Copper280z/nucleo144_driver_breakout/nucleo_driver_breakout/nucleo_driver_breakout.kicad_pcb

## KiCad design nucleo_driver_breakout/nucleo_driver_breakout.kicad_pcb (2024-06-16)

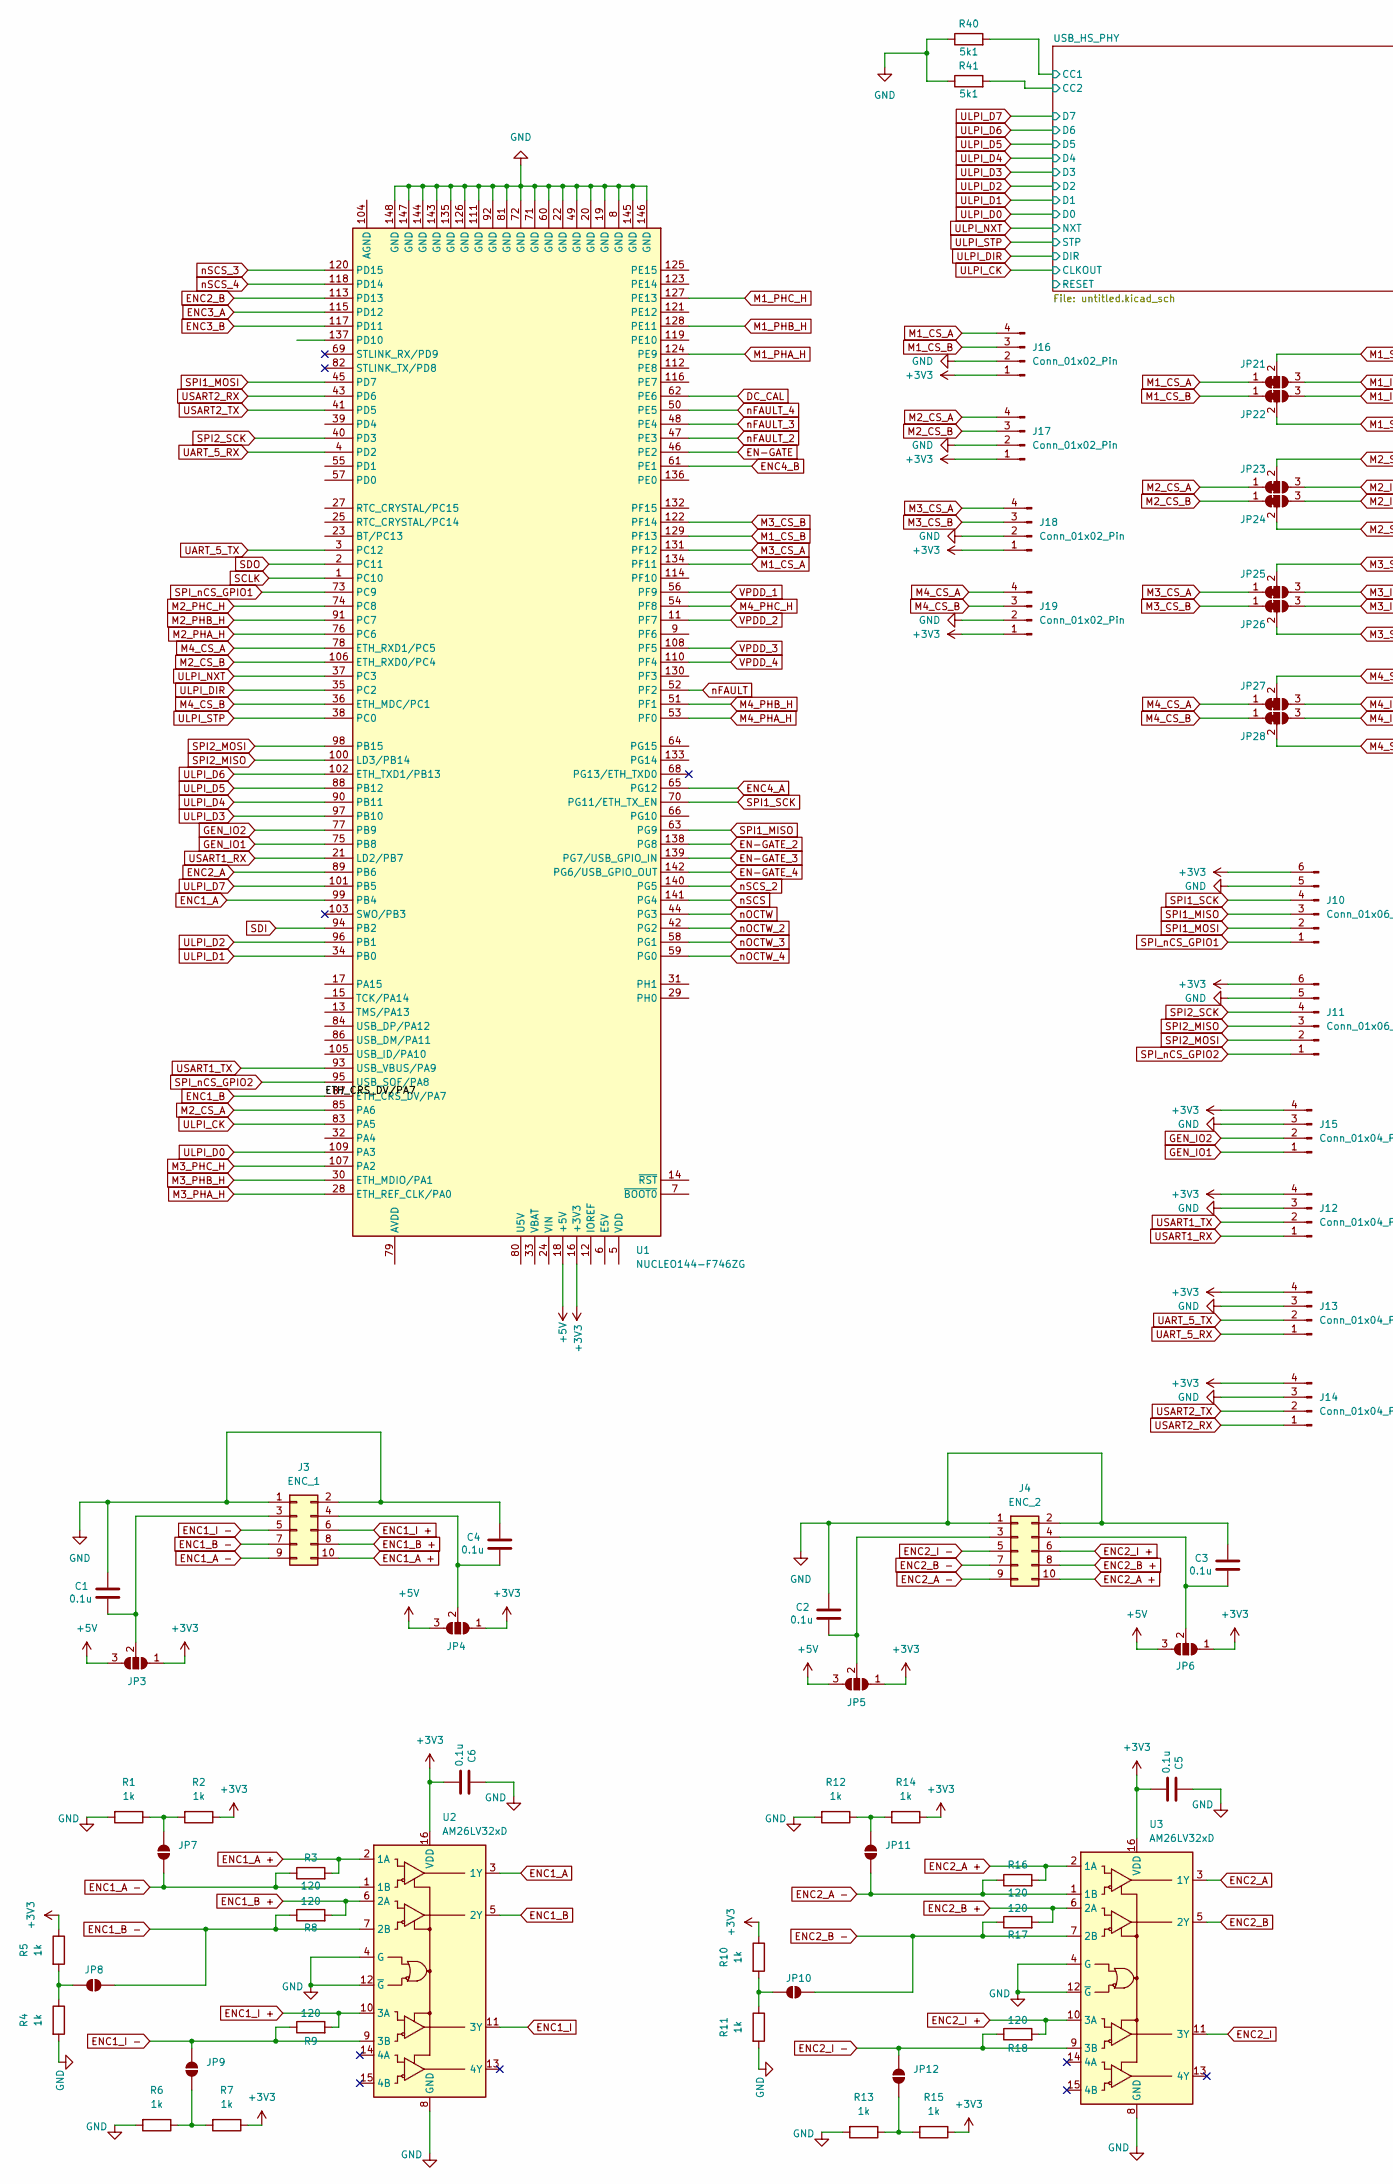
[picture p1: schematic nucleo_driver_breakout.kicad_sch, part in row 1, column 1]

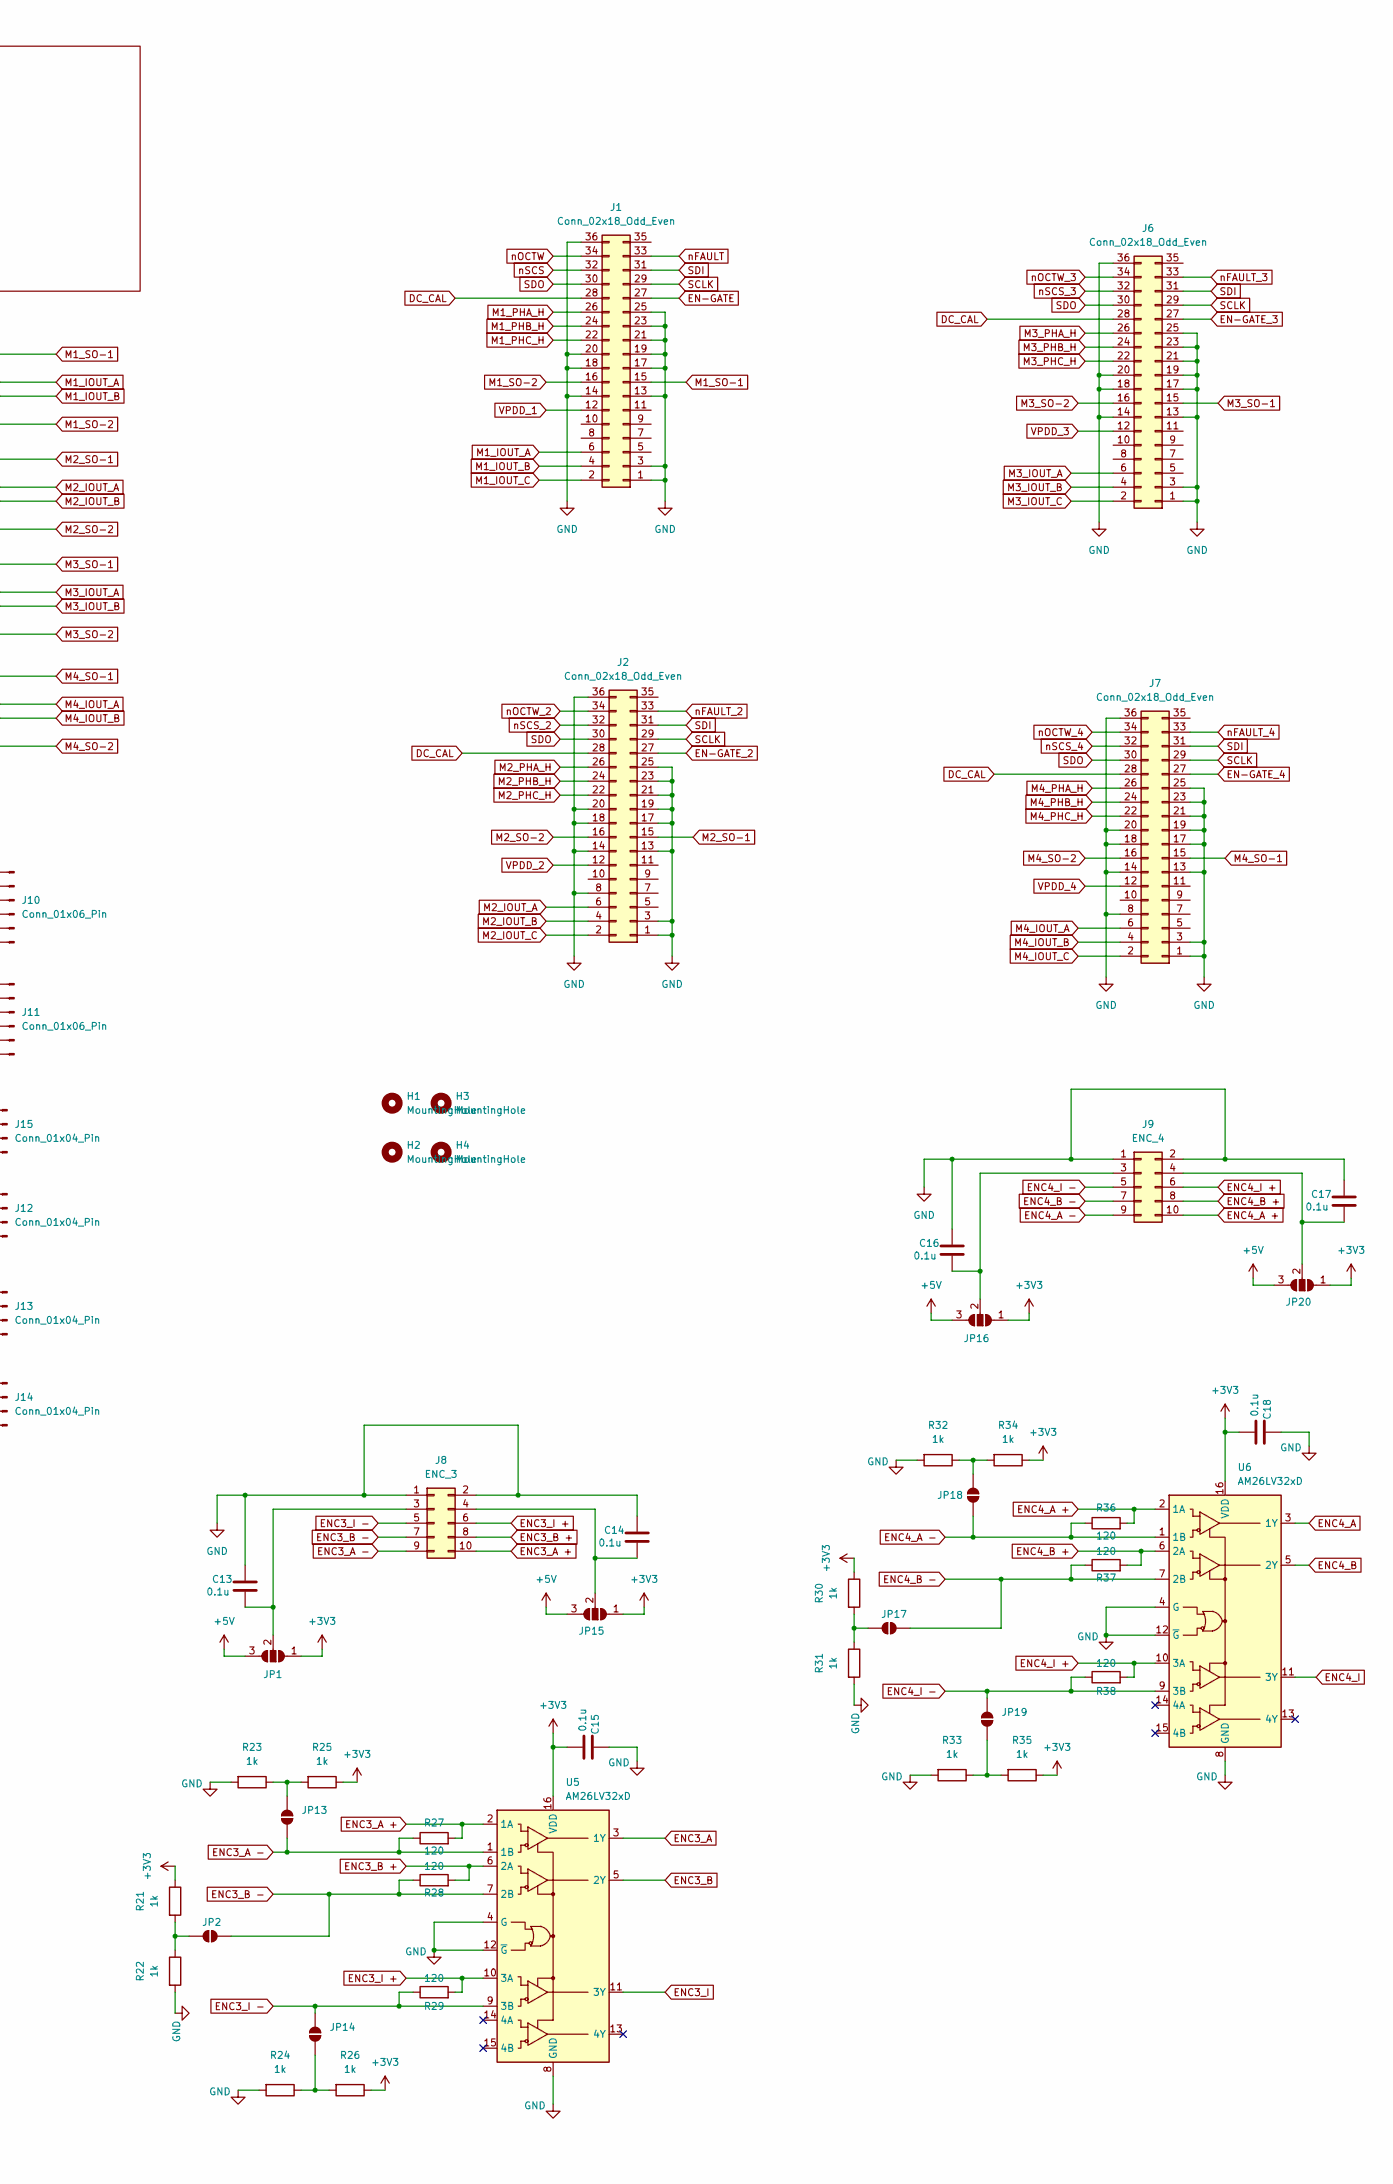
[picture p2: schematic nucleo_driver_breakout.kicad_sch, part in row 1, column 2]

Parts:
C1, C2, C3, C4, C5, C6, C13, C14, C15, C16, C17, C18: 0.1u; C_0402_1005Metric; LCSC ID C1525
H1, H2, H3, H4: MountingHole; MountingHole_3.2mm_M3_ISO7380
J1, J2, J6, J7: Conn_02x18_Odd_Even; PinHeader_2x18_P2.54mm_Vertical
J3: ENC_1; PinHeader_2x05_P2.54mm_Vertical
J4: ENC_2; PinHeader_2x05_P2.54mm_Vertical
J8: ENC_3; PinHeader_2x05_P2.54mm_Vertical
J9: ENC_4; PinHeader_2x05_P2.54mm_Vertical
J10, J11: Conn_01x06_Pin; JST_EH_B6B-EH-A_1x06_P2.50mm_Vertical
J12, J13, J14, J15: Conn_01x04_Pin; JST_EH_B4B-EH-A_1x04_P2.50mm_Vertical
J16, J17, J18, J19: Conn_01x02_Pin; JST_EH_B4B-EH-A_1x04_P2.50mm_Vertical
JP1, JP3, JP4, JP5, JP6, JP15, JP16, JP20: SolderJumper_3_Open; SolderJumper-3_P1.3mm_Open_RoundedPad1.0x1.5mm
JP2, JP7, JP8, JP9, JP10, JP11, JP12, JP13, JP14, JP17, JP18, JP19: SolderJumper_2_Open; SolderJumper-2_P1.3mm_Open_RoundedPad1.0x1.5mm
JP21, JP22, JP23, JP24, JP25, JP26, JP27, JP28: SolderJumper_3_Bridged12; SolderJumper-3_P1.3mm_Bridged12_RoundedPad1.0x1.5mm
R1, R2, R4, R5, R6, R7, R10, R11, R12, R13, R14, R15, R21, R22, R23, R24, R25, R26, R30, R31, R32, R33, R34, R35: 1k; R_0402_1005Metric; LCSC ID C11702
R3, R8, R9, R16, R17, R18, R27, R28, R29, R36, R37, R38: 120; R_1206_3216Metric; LCSC ID C17909
R40: 5k1; R_0402_1005Metric; LCSC ID C25079
R41: 5k1; R_0402_1005Metric; LCSC ID C25905
U1: NUCLEO144-F746ZG; ST_Morpho_Connector_144_STLink
U2, U3, U5, U6: AM26LV32xD; SOIC-16_3.9x9.9mm_P1.27mm; LCSC ID C524786

Connections:
+3V3: C5.2, C6.2, C15.2, C18.2, J10.6, J11.6, J12.4, J13.4, J14.4, J15.4, J16.1, J17.1, J18.1, J19.1, JP1.1 (A), JP3.1 (A), JP4.1 (A), JP5.1 (A), JP6.1 (A), JP15.1 (A), JP16.1 (A), JP20.1 (A), R2.1, R5.1, R7.1, R10.1, R14.1, R15.1, R21.1, R25.1, R26.1, R30.1, R34.1, R35.1, U1.16 (+3V3), U2.16 (VDD), U3.16 (VDD), U5.16 (VDD), U6.16 (VDD); also elsewhere on the board
+5V: JP1.3 (B), JP3.3 (B), JP4.3 (B), JP5.3 (B), JP6.3 (B), JP15.3 (B), JP16.3 (B), JP20.3 (B), U1.18 (+5V)
/USB_HS_PHY/CC1: R40.2; also elsewhere on the board
/USB_HS_PHY/CC2: R41.2; also elsewhere on the board
DC_CAL: J1.28, J2.28, J6.28, J7.28, U1.62 (PE6)
EN-GATE: J1.27, U1.46 (PE2)
EN-GATE_2: J2.27, U1.138 (PG8)
EN-GATE_3: J6.27, U1.139 (PG7/USB_GPIO_IN)
EN-GATE_4: J7.27, U1.142 (PG6/USB_GPIO_OUT)
ENC1_A: U1.99 (PB4), U2.3 (1Y)
ENC1_A +: J3.10, R3.2, U2.2 (1A)
ENC1_A -: J3.9, JP7.1 (A), R3.1, U2.1 (1B)
ENC1_B: U1.87 (ETH_CRS_DV/PA7), U2.5 (2Y)
ENC1_B +: J3.8, R8.2, U2.6 (2A)
ENC1_B -: J3.7, JP8.1 (A), R8.1, U2.7 (2B)
ENC1_I: U2.11 (3Y)
ENC1_I +: J3.6, R9.2, U2.10 (3A)
ENC1_I -: J3.5, JP9.1 (A), R9.1, U2.9 (3B)
ENC2_A: U1.89 (PB6), U3.3 (1Y)
ENC2_A +: J4.10, R16.2, U3.2 (1A)
ENC2_A -: J4.9, JP11.1 (A), R16.1, U3.1 (1B)
ENC2_B: U1.113 (PD13), U3.5 (2Y)
ENC2_B +: J4.8, R17.2, U3.6 (2A)
ENC2_B -: J4.7, JP10.1 (A), R17.1, U3.7 (2B)
ENC2_I: U3.11 (3Y)
ENC2_I +: J4.6, R18.2, U3.10 (3A)
ENC2_I -: J4.5, JP12.1 (A), R18.1, U3.9 (3B)
ENC3_A: U1.115 (PD12), U5.3 (1Y)
ENC3_A +: J8.10, R27.2, U5.2 (1A)
ENC3_A -: J8.9, JP13.1 (A), R27.1, U5.1 (1B)
ENC3_B: U1.117 (PD11), U5.5 (2Y)
ENC3_B +: J8.8, R28.2, U5.6 (2A)
ENC3_B -: J8.7, JP2.1 (A), R28.1, U5.7 (2B)
ENC3_I: U5.11 (3Y)
ENC3_I +: J8.6, R29.2, U5.10 (3A)
ENC3_I -: J8.5, JP14.1 (A), R29.1, U5.9 (3B)
ENC4_A: U1.65 (PG12), U6.3 (1Y)
ENC4_A +: J9.10, R36.2, U6.2 (1A)
ENC4_A -: J9.9, JP18.1 (A), R36.1, U6.1 (1B)
ENC4_B: U1.61 (PE1), U6.5 (2Y)
ENC4_B +: J9.8, R37.2, U6.6 (2A)
ENC4_B -: J9.7, JP17.1 (A), R37.1, U6.7 (2B)
ENC4_I: U6.11 (3Y)
ENC4_I +: J9.6, R38.2, U6.10 (3A)
ENC4_I -: J9.5, JP19.1 (A), R38.1, U6.9 (3B)
GEN_IO1: J15.1, U1.75 (PB8)
GEN_IO2: J15.2, U1.77 (PB9)
GND: C1.1, C2.1, C3.1, C4.1, C5.1, C6.1, C13.1, C14.1, C15.1, C16.1, C17.1, C18.1, J1.1, J1.3, J1.13, J1.14, J1.17, J1.18, J1.19, J1.20, J1.21, J1.23, J1.25, J1.36, J2.1, J2.3, J2.8, J2.13, J2.14, J2.17, J2.18, J2.19, J2.20, J2.21, J2.23, J2.25, J2.36, J3.1, J3.2, J4.1, J4.2, J6.1, J6.3, J6.13, J6.14, J6.17, J6.18, J6.19, J6.20, J6.21, J6.23, J6.25, J6.36, J7.1, J7.3, J7.8, J7.13, J7.14, J7.17, J7.18, J7.19, J7.20, J7.21, J7.23, J7.25, J7.36, J8.1, J8.2, J9.1, J9.2, J10.5, J11.5, J12.3, J13.3, J14.3, J15.3, J16.2, J17.2, J18.2, J19.2, R1.2, R4.2, R6.2, R11.2, R12.2, R13.2, R22.2, R23.2, R24.2, R31.2, R32.2, R33.2, R40.1, R41.1, U1.8 (GND), U1.19 (GND), U1.20 (GND), U1.22 (GND), U1.49 (GND), U1.60 (GND), U1.71 (GND), U1.72 (GND), U1.81 (GND), U1.92 (GND), U1.111 (GND), U1.126 (GND), U1.135 (GND), U1.143 (GND), U1.144 (GND), U1.145 (GND), U1.146 (GND), U1.147 (GND), U1.148 (GND), U2.4 (G), U2.8 (GND), U2.12 (~G), U3.4 (G), U3.8 (GND), U3.12 (~G), U5.4 (G), U5.8 (GND), U5.12 (~G), U6.4 (G), U6.8 (GND), U6.12 (~G); also elsewhere on the board
M1_CS_A: J16.4, JP21.1 (A), U1.134 (PF11)
M1_CS_B: J16.3, JP22.1 (A), U1.129 (PF13)
M1_IOUT_A: J1.6, JP21.3 (B)
M1_IOUT_B: J1.4, JP22.3 (B)
M1_IOUT_C: J1.2
M1_PHA_H: J1.26, U1.124 (PE9)
M1_PHB_H: J1.24, U1.128 (PE11)
M1_PHC_H: J1.22, U1.127 (PE13)
M1_SO-1: J1.15, JP21.2 (C)
M1_SO-2: J1.16, JP22.2 (C)
M2_CS_A: J17.4, JP23.1 (A), U1.85 (PA6)
M2_CS_B: J17.3, JP24.1 (A), U1.106 (ETH_RXD0/PC4)
M2_IOUT_A: J2.6, JP23.3 (B)
M2_IOUT_B: J2.4, JP24.3 (B)
M2_IOUT_C: J2.2
M2_PHA_H: J2.26, U1.76 (PC6)
M2_PHB_H: J2.24, U1.91 (PC7)
M2_PHC_H: J2.22, U1.74 (PC8)
M2_SO-1: J2.15, JP23.2 (C)
M2_SO-2: J2.16, JP24.2 (C)
M3_CS_A: J18.4, JP25.1 (A), U1.131 (PF12)
M3_CS_B: J18.3, JP26.1 (A), U1.122 (PF14)
M3_IOUT_A: J6.6, JP25.3 (B)
M3_IOUT_B: J6.4, JP26.3 (B)
M3_IOUT_C: J6.2
M3_PHA_H: J6.26, U1.28 (ETH_REF_CLK/PA0)
M3_PHB_H: J6.24, U1.30 (ETH_MDIO/PA1)
M3_PHC_H: J6.22, U1.107 (PA2)
M3_SO-1: J6.15, JP25.2 (C)
M3_SO-2: J6.16, JP26.2 (C)
M4_CS_A: J19.4, JP27.1 (A), U1.78 (ETH_RXD1/PC5)
M4_CS_B: J19.3, JP28.1 (A), U1.36 (ETH_MDC/PC1)
M4_IOUT_A: J7.6, JP27.3 (B)
M4_IOUT_B: J7.4, JP28.3 (B)
M4_IOUT_C: J7.2
M4_PHA_H: J7.26, U1.53 (PF0)
M4_PHB_H: J7.24, U1.51 (PF1)
M4_PHC_H: J7.22, U1.54 (PF8)
M4_SO-1: J7.15, JP27.2 (C)
M4_SO-2: J7.16, JP28.2 (C)
unnamed: C1.2, J3.3, JP3.2 (C)
unnamed: C4.2, J3.4, JP4.2 (C)
unnamed: C2.2, J4.3, JP5.2 (C)
unnamed: C3.2, J4.4, JP6.2 (C)
unnamed: C13.2, J8.3, JP1.2 (C)
unnamed: C14.2, J8.4, JP15.2 (C)
unnamed: C16.2, J9.3, JP16.2 (C)
unnamed: C17.2, J9.4, JP20.2 (C)
unnamed: JP2.2 (B), R21.2, R22.1
unnamed: JP7.2 (B), R1.1, R2.2
unnamed: JP8.2 (B), R4.1, R5.2
unnamed: JP9.2 (B), R6.1, R7.2
unnamed: JP10.2 (B), R10.2, R11.1
unnamed: JP11.2 (B), R12.1, R14.2
unnamed: JP12.2 (B), R13.1, R15.2
unnamed: JP13.2 (B), R23.1, R25.2
unnamed: JP14.2 (B), R24.1, R26.2
unnamed: JP17.2 (B), R30.2, R31.1
unnamed: JP18.2 (B), R32.1, R34.2
unnamed: JP19.2 (B), R33.1, R35.2
SCLK: J1.29, J2.29, J6.29, J7.29, U1.1 (PC10)
SDI: J1.31, J2.31, J6.31, J7.31, U1.94 (PB2)
SDO: J1.30, J2.30, J6.30, J7.30, U1.2 (PC11)
SPI1_MISO: J10.3, U1.63 (PG9)
SPI1_MOSI: J10.2, U1.45 (PD7)
SPI1_SCK: J10.4, U1.70 (PG11/ETH_TX_EN)
SPI2_MISO: J11.3, U1.100 (LD3/PB14)
SPI2_MOSI: J11.2, U1.98 (PB15)
SPI2_SCK: J11.4, U1.40 (PD3)
SPI_nCS_GPIO1: J10.1, U1.73 (PC9)
SPI_nCS_GPIO2: J11.1, U1.95 (USB_SOF/PA8)
UART_5_RX: J13.1, U1.4 (PD2)
UART_5_TX: J13.2, U1.3 (PC12)
ULPI_CK: U1.83 (PA5); also elsewhere on the board
ULPI_D0: U1.109 (PA3); also elsewhere on the board
ULPI_D1: U1.34 (PB0); also elsewhere on the board
ULPI_D2: U1.96 (PB1); also elsewhere on the board
ULPI_D3: U1.97 (PB10); also elsewhere on the board
ULPI_D4: U1.90 (PB11); also elsewhere on the board
ULPI_D5: U1.88 (PB12); also elsewhere on the board
ULPI_D6: U1.102 (ETH_TXD1/PB13); also elsewhere on the board
ULPI_D7: U1.101 (PB5); also elsewhere on the board
ULPI_DIR: U1.35 (PC2); also elsewhere on the board
ULPI_NXT: U1.37 (PC3); also elsewhere on the board
ULPI_STP: U1.38 (PC0); also elsewhere on the board
USART1_RX: J12.1, U1.21 (LD2/PB7)
USART1_TX: J12.2, U1.93 (USB_VBUS/PA9)
USART2_RX: J14.1, U1.43 (PD6)
USART2_TX: J14.2, U1.41 (PD5)
VPDD_1: J1.12, U1.56 (PF9)
VPDD_2: J2.12, U1.11 (PF7)
VPDD_3: J6.12, U1.108 (PF5)
VPDD_4: J7.12, U1.110 (PF4)
nFAULT: J1.33, U1.52 (PF2)
nFAULT_2: J2.33, U1.47 (PE3)
nFAULT_3: J6.33, U1.48 (PE4)
nFAULT_4: J7.33, U1.50 (PE5)
nOCTW: J1.34, U1.44 (PG3)
nOCTW_2: J2.34, U1.42 (PG2)
nOCTW_3: J6.34, U1.58 (PG1)
nOCTW_4: J7.34, U1.59 (PG0)
nSCS: J1.32, U1.141 (PG4)
nSCS_2: J2.32, U1.140 (PG5)
nSCS_3: J6.32, U1.120 (PD15)
nSCS_4: J7.32, U1.118 (PD14)

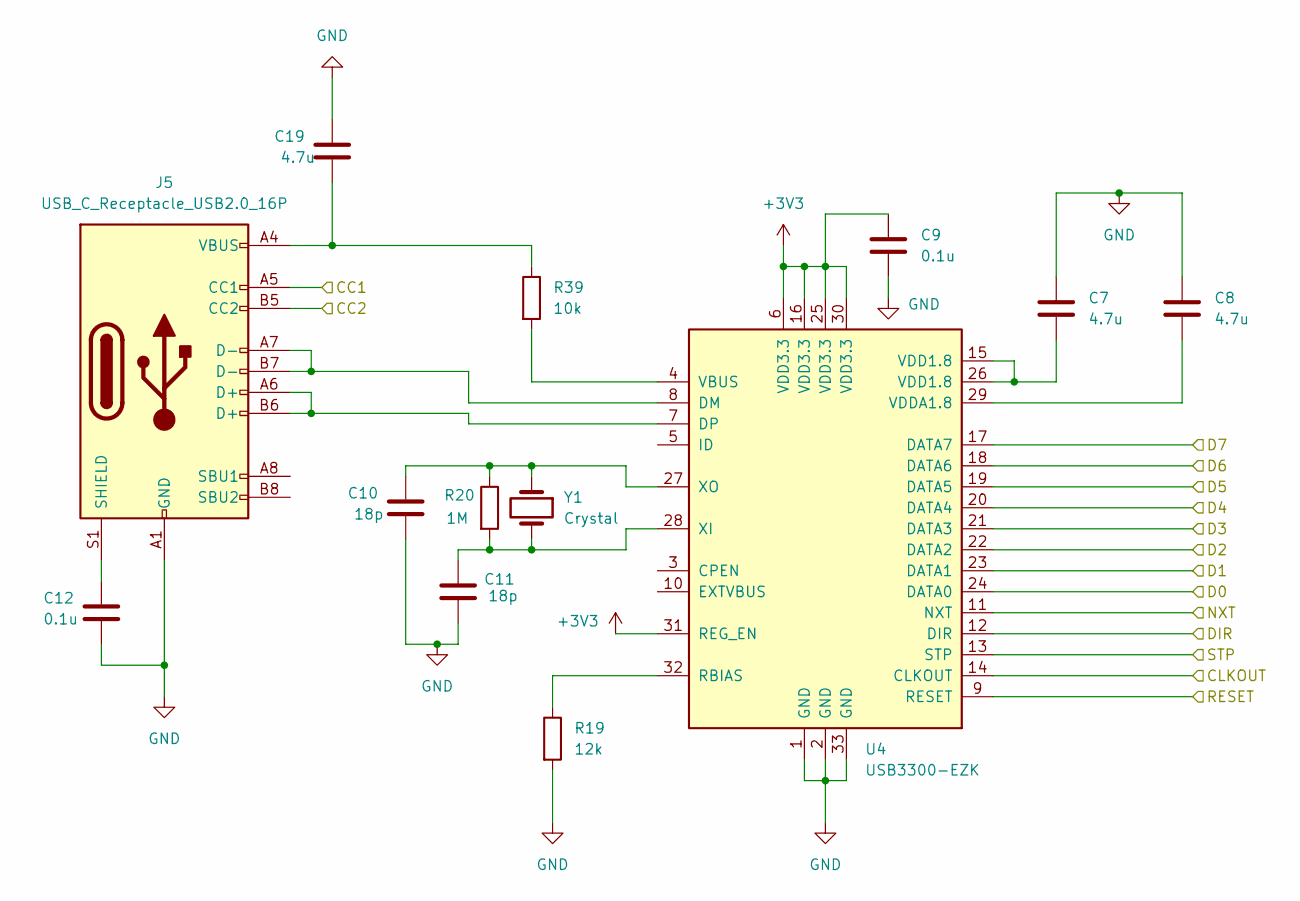
[picture p3: schematic untitled.kicad_sch]

Parts:
C7, C8: 4.7u; C_0402_1005Metric; LCSC ID C2858031
C9, C12: 0.1u; C_0402_1005Metric; LCSC ID C1525
C10, C11: 18p; C_0402_1005Metric; LCSC ID C1512022
C19: 4.7u; C_0402_1005Metric; LCSC ID C695126
J5: USB_C_Receptacle_USB2.0_16P; USB_C_Receptacle_G-Switch_GT-USB-7010ASV; LCSC ID C2988369
R19: 12k; R_0402_1005Metric; LCSC ID C25752
R20: 1M; R_0402_1005Metric
R39: 10k; R_0402_1005Metric; LCSC ID C25744
U4: USB3300-EZK; QFN-32-1EP_5x5mm_P0.5mm_EP3.45x3.45mm; LCSC ID C108383
Y1: Crystal; Crystal_SMD_Qantek_QC5CB-2Pin_5x3.2mm; LCSC ID C1985382

Connections:
+3V3: C9.1, U4.6 (VDD3.3), U4.16 (VDD3.3), U4.25 (VDD3.3), U4.30 (VDD3.3), U4.31 (REG_EN); also elsewhere on the board
/USB_HS_PHY/CC1: J5.A5 (CC1); also elsewhere on the board
/USB_HS_PHY/CC2: J5.B5 (CC2); also elsewhere on the board
/USB_HS_PHY/RESET: U4.9 (RESET)
GND: C7.1, C8.1, C9.2, C10.2, C11.2, C12.2, C19.1, J5.A1 (GND), J5.A12 (GND), J5.B1 (GND), J5.B12 (GND), R19.2, U4.1 (GND), U4.2 (GND), U4.33 (GND); also elsewhere on the board
unnamed: C7.2, U4.15 (VDD1.8), U4.26 (VDD1.8)
unnamed: C19.2, J5.A4 (VBUS), J5.A9 (VBUS), J5.B4 (VBUS), J5.B9 (VBUS), R39.1
unnamed: C12.1, J5.S1 (SHIELD)
unnamed: J5.A7 (D-), J5.B7 (D-), U4.8 (DM)
unnamed: J5.A6 (D+), J5.B6 (D+), U4.7 (DP)
unnamed: R19.1, U4.32 (RBIAS)
unnamed: R39.2, U4.4 (VBUS)
unnamed: C8.2, U4.29 (VDDA1.8)
unnamed: C11.1, R20.2, U4.28 (XI), Y1.2
unnamed: C10.1, R20.1, U4.27 (XO), Y1.1
ULPI_CK: U4.14 (CLKOUT); also elsewhere on the board
ULPI_D0: U4.24 (DATA0); also elsewhere on the board
ULPI_D1: U4.23 (DATA1); also elsewhere on the board
ULPI_D2: U4.22 (DATA2); also elsewhere on the board
ULPI_D3: U4.21 (DATA3); also elsewhere on the board
ULPI_D4: U4.20 (DATA4); also elsewhere on the board
ULPI_D5: U4.19 (DATA5); also elsewhere on the board
ULPI_D6: U4.18 (DATA6); also elsewhere on the board
ULPI_D7: U4.17 (DATA7); also elsewhere on the board
ULPI_DIR: U4.12 (DIR); also elsewhere on the board
ULPI_NXT: U4.11 (NXT); also elsewhere on the board
ULPI_STP: U4.13 (STP); also elsewhere on the board

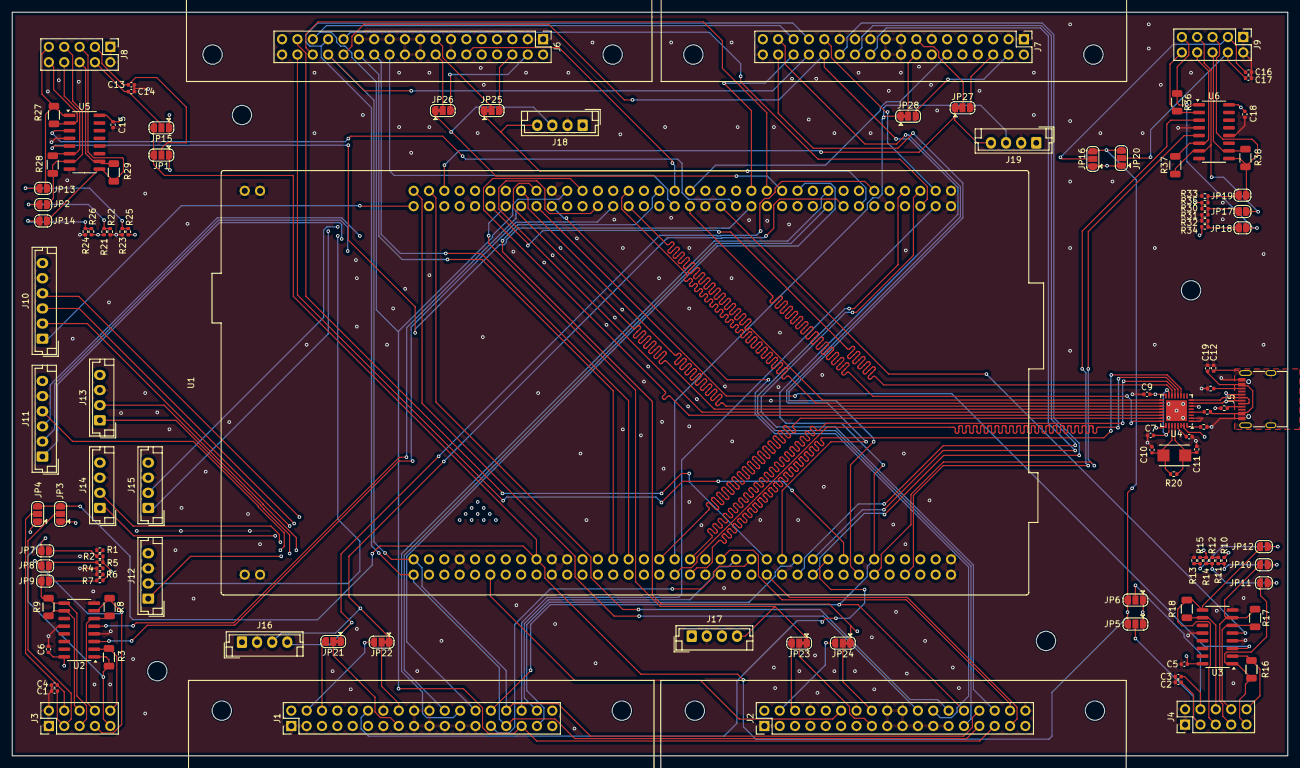
[picture p4: board nucleo_driver_breakout.kicad_pcb from above]

Board: 4 copper layers, 211.0 x 123.0 mm, 118 parts (0 on the bottom side), 155 nets.
