Copper280z/nucleo144_driver_breakout/nucleo_driver_board.ioc

Mcu.UserName=STM32H723ZGTx
PA0.GPIO_Label=M3_PHA_TIM2_CH1
PA0.Signal=S_TIM2_CH1_ETR
PA1.GPIO_Label=M3_PHB_TIM2_CH2
PA1.Signal=S_TIM2_CH2
PA13(JTMS/SWDIO).Signal=DEBUG_JTMS-SWDIO
PA14(JTCK/SWCLK).Signal=DEBUG_JTCK-SWCLK
PA15(JTDI).Signal=GPIO_Output
PA2.GPIO_Label=M3_PHC_TIM2_CH3
PA2.Signal=S_TIM2_CH3
PA3.Signal=USB_OTG_HS_ULPI_D0
PA5.Signal=USB_OTG_HS_ULPI_CK
PA6.GPIO_Label=M2_CS_A_ADC1_IN3
PA6.Signal=ADCx_INP3
PA7.GPIO_Label=ENC1_B_TIM3_CH2
PA7.Signal=S_TIM3_CH2
PA8.Signal=GPIO_Output
PA9.Signal=USART1_TX
PB0.Signal=USB_OTG_HS_ULPI_D1
PB1.Signal=USB_OTG_HS_ULPI_D2
PB10.Signal=USB_OTG_HS_ULPI_D3
PB11.Signal=USB_OTG_HS_ULPI_D4
PB12.Signal=USB_OTG_HS_ULPI_D5
PB13.Signal=USB_OTG_HS_ULPI_D6
PB14.Signal=SPI2_MISO
PB15.Signal=SPI2_MOSI
PB2.GPIO_Label=MDRV_SDI_SPI3_MOSI
PB2.Signal=SPI3_MOSI
PB3(JTDO/TRACESWO).Signal=DEBUG_JTDO-SWO
PB4(NJTRST).GPIO_Label=ENC1_A_TIM3_CH1
PB4(NJTRST).Signal=S_TIM3_CH1
PB5.Signal=USB_OTG_HS_ULPI_D7
PB6.GPIO_Label=ENC2_A_TIM4_CH1
PB6.Signal=S_TIM4_CH1
PB7.Signal=USART1_RX
PC0.Signal=USB_OTG_HS_ULPI_STP
PC1.GPIO_Label=M4_CS_B_ADC2_IN11
PC1.Signal=ADCx_INP11
PC10.GPIO_Label=MDRV_SCLK_SPI3_SCK
PC10.Signal=SPI3_SCK
PC11.GPIO_Label=MDRV_SDO_SPI3_MISO
PC11.Signal=SPI3_MISO
PC12.Signal=UART5_TX
PC13.GPIO_Label=USR_BTN
PC13.Signal=GPIO_Input
PC2_C.Signal=USB_OTG_HS_ULPI_DIR
PC3_C.Signal=USB_OTG_HS_ULPI_NXT
PC4.GPIO_Label=M2_CS_B_ADC2_IN4
PC4.Signal=ADCx_INP4
PC5.GPIO_Label=M4_CS_A_ADC1_IN8
PC5.Signal=ADCx_INP8
PC6.GPIO_Label=M2_PHA_TIM8_CH1
PC6.Signal=S_TIM8_CH1
PC7.GPIO_Label=M2_PHB_TIM8_CH2
PC7.Signal=S_TIM8_CH2
PC8.GPIO_Label=M2_PHC_TIM8_CH3
PC8.Signal=S_TIM8_CH3
PC9.GPIO_Label=AUX_SPI_nCS
PC9.Signal=GPIO_Output
PD0.Signal=GPIO_Output
PD1.Signal=GPIO_Output
PD11.GPIO_Label=ENC3_B_LPTIM2_IN2
PD11.Signal=LPTIM2_IN2
PD12.GPIO_Label=ENC3_A_LPTIM2_IN1
PD12.Signal=LPTIM2_IN1
PD13.GPIO_Label=ENC2_B_TIM4_CH2
PD13.Signal=S_TIM4_CH2
PD14.GPIO_Label=nSCS_4
PD14.Signal=GPIO_Output
PD15.GPIO_Label=nSCS_3
PD15.Signal=GPIO_Output
PD2.Signal=UART5_RX
PD3.Signal=SPI2_SCK
PD5.Signal=USART2_TX
PD6.Signal=USART2_RX
PD7.Signal=SPI1_MOSI
PD8.Signal=USART3_TX
PD9.Signal=USART3_RX
PE1.GPIO_Label=ENC4_B_LPTIM1_IN2
PE1.Signal=LPTIM1_IN2
PE11.GPIO_Label=M1_PHB_TIM1_CH2
PE11.Signal=S_TIM1_CH2
PE13.GPIO_Label=M1_PHC_TIM1_CH3
PE13.Signal=S_TIM1_CH3
PE2.GPIO_Label=EN-GATE
PE2.Signal=GPIO_Output
PE3.GPIO_Label=nFAULT_2
PE3.Signal=GPIO_Input
PE4.GPIO_Label=nFAULT_3
PE4.Signal=GPIO_Input
PE5.GPIO_Label=nFAULT_4
PE5.Signal=GPIO_Input
PE6.GPIO_Label=DC_CAL
PE6.Signal=GPIO_Output
PE9.GPIO_Label=M1_PHA_TIM1_CH1
PE9.Signal=S_TIM1_CH1
PF0.GPIO_Label=M4_PHA_TIM23_CH1
PF0.Signal=TIM23_CH1
PF1.GPIO_Label=M4_PHA_TIM23_CH2
PF1.Signal=S_TIM23_CH2
PF11.GPIO_Label=M1_CS_A_ADC1_IN2
PF11.Signal=ADC1_INP2
PF12.GPIO_Label=M3_CS_A_ADC1_IN6
PF12.Signal=ADC1_INP6
PF13.GPIO_Label=M1_CS_B_ADC2_IN2
PF13.Signal=ADC2_INP2
PF14.GPIO_Label=M3_CS_B_ADC2_IN6
PF14.Signal=ADC2_INP6
PF2.GPIO_Label=nFAULT
PF2.Signal=GPIO_Input
PF3.GPIO_Label=VPDD_4_ADC3_IN5
PF3.Signal=ADC3_INP5
PF5.GPIO_Label=VPDD_3_ADC3_IN4
PF5.Signal=ADC3_INP4
PF7.GPIO_Label=VPDD_2_ADC3_IN3
PF7.Signal=ADC3_INP3
PF9.GPIO_Label=VPDD_1_ADC3_IN2
PF9.Signal=ADC3_INP2
PG0.Signal=GPIO_Input
PG1.GPIO_Label=nOCTW_3
PG1.Signal=GPIO_Input
PG11.Signal=SPI1_SCK
PG12.GPIO_Label=ENC4_A_LPTIM1_IN1
PG12.Signal=LPTIM1_IN1
PG14.GPIO_Label=M4_PHC_TIM23_CH3
PG14.Signal=S_TIM23_CH3
PG2.GPIO_Label=nOCTW_2
PG2.Signal=GPIO_Input
PG3.GPIO_Label=nOCTW
PG3.Signal=GPIO_Input
PG4.GPIO_Label=nSCS
PG4.Signal=GPIO_Output
PG5.Signal=GPIO_Output
PG6.GPIO_Label=EN-GATE_4
PG6.Signal=GPIO_Output
PG7.GPIO_Label=EN-GATE_3
PG7.Signal=GPIO_Output
PG8.GPIO_Label=EN-GATE_2
PG8.Signal=GPIO_Output
PG9.Signal=SPI1_MISO
