Copper280z/nucleo144_driver_breakout/(commit log)

2024-06-12 first board rev
    [nucleo_driver_breakout.kicad_pcb, nucleo_driver_breakout.kicad_sch, untitled.kicad_sch]
2024-06-12 added current sense header for each motor
    [nucleo_driver_breakout.kicad_pcb, nucleo_driver_breakout.kicad_sch]
2024-06-12 changed usb connector and added LCSC IDs
    [nucleo_driver_breakout.kicad_pcb, nucleo_driver_breakout.kicad_sch, untitled.kicad_sch]
2024-06-13 added bolt holes, vias, and fixed some silkscreen overlaps
    [bom.csv, nucleo_driver_breakout.csv, nucleo_driver_breakout.kicad_pcb, nucleo_driver_breakout.kicad_sch, untitled.kicad_sch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]
2024-06-16 changed termination resistors to 1206 and added gitignore
    [nucleo_driver_breakout.csv, nucleo_driver_breakout.kicad_pcb, nucleo_driver_breakout.kicad_sch]
